akhilamokkapati/pass/actuation/Firmware/data/calibration_run2.csv

weight | measured | fitted | residual
1.200 | -53240.00 | -50995.75 | -2244.25
7.600 | -223719.00 | -223210.56 | -508.44
9.600 | -257718.00 | -277027.69 | 19309.69
10.800 | -325875.00 | -309317.97 | -16557.03
