akhilamokkapati/pass/actuation/Firmware/prototyping/strain_gauge_plot_c3.cpp

// Strain gauge test via HX711 (bridge completed with 3 fixed resistors),
// XIAO ESP32-C3. Formatted output (>name:value) for live plotting.
// Duplicate of strain_gauge_plot.cpp (S3) for the C3 board on COM14.

#include <Arduino.h>
#include <HX711.h>

const int HX711_DT = D9;
const int HX711_SCK = D10;

HX711 scale;

unsigned long lastPrintMs = 0;
const unsigned long PRINT_INTERVAL_MS = 200;

void setup() {
  Serial.begin(115200);
  delay(500);

  scale.begin(HX711_DT, HX711_SCK);
}

void loop() {
  unsigned long now = millis();
  if (now - lastPrintMs < PRINT_INTERVAL_MS) return;
  lastPrintMs = now;

  if (scale.is_ready()) {
    Serial.print(">strain:");
    Serial.println(-scale.read());
  } else {
    Serial.println(F("HX711 not ready"));
  }
}
