akhilamokkapati/pass/(commit log)

2026-07-12 knee firmware: fix frozen shank IMU with hardened BNO085 bring-up
    The shank streamed a frozen identity quaternion because
    enableGameRotationVector() was issued immediately after begin(), inside
    the BNO085 post-reset boot window, so the feature command was silently
    dropped and dataAvailable() never fired. The thigh only survived by
    incidental timing.
    Fix:
    - 200 ms boot delay after Wire setup before the first begin().
    - Shared initSensor() helper: up to 3 begin() retries (100 ms apart),
    then 150 ms before and 50 ms after enableGameRotationVector().
    - loop() per-sensor liveness watchdog: re-enable the report and print a
    '#' warning if a found sensor goes silent for >1 s.
    - Periodic '#' hea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
    [knee_imu_serial.ino]
2026-07-25 feet: add left insole channel-map doc + live pressure-map viewer
    Hardware bring-up docs and a bring-up/demo tool for the left foot FS-INS-16Z
    insole (XIAO ESP32-S3, CD74HC4067 mux, pull-up topology).
    - feet/docs/left_insole_channel_map.md: source-of-truth hardware reference -
    pin map (explicit GPIO), mux channel map, COMMON/NUL, pull-up + inversion
    requirement, ADC read routine, and a configurable channel-to-anatomy table
    (C8/C9 big toe and C12/C13 heel confirmed, rest TODO).
    - feet/insole_pressure_map.py: live foot heatmap that reads the 16-channel serial
    scan, inverts (pull-up) so pressure reads up, auto-baselines each zone, and
    doubles as the press-test tool. Positions/anatomy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
    [insole_pressure_map.py]
2026-07-25 feet: add insole data source + per-zone normalization, wire into viewer
    Task 3 - feet/sources/insole_source.py: InsoleSource mirrors the knee serial
    source interface (stream/get_data, lazy pyserial, injectable line_source for
    tests) with its own InsoleFrame/InsoleCapture (schema.py). Inverts each channel
    (4095 - raw) so pressure reads up.
    Task 4 - feet/sources/normalize.py: ZoneNormalizer fits a standing-still segment
    and rescales to fraction-of-static-load per zone (corrects zone-to-zone
    sensitivity), re-runnable per session.
    feet/insole_pressure_map.py now reads through the source and gains a normalized
    mode: press 'c' while standing to calibrate, then the map shows fraction of
    standing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
    [insole_pressure_map.py, insole_source.py, normalize.py, schema.py, test_insole_source.py]
2026-07-28 feet: add right insole channel map (differs from left)
    Right foot has a different physical-pin to mux-channel map and different
    COMMON/NUL pins than the left (phys 6,14 = GND; phys 1,11 = NUL). Same physical
    pin can be a sensor zone on one foot and GND on the other, so the feet keep
    separate maps. All 16 mux channels C0-C15 are live on both feet (no dead
    channels). Channel-to-anatomy left TODO pending the press test.
2026-07-28 feet: dual both-feet live pressure viewer + confirmed left layout
    - feet/foot_layout.py: configurable per-foot zone layouts. LEFT is the confirmed
    press-test layout (cross-checked against the pin->channel map); RIGHT provisional.
    - feet/insole_dual_view.py: both feet side by side, each on its own serial port,
    with 'c' to calibrate both to standing load and 'r' to re-zero; a missing port
    degrades to "not connected" without stopping the other foot.
    - left_insole_channel_map.md: fill the anatomy table from the press-test layout,
    and add the 220k pull-up mounting/range notes (mux board SIG-VCC pad, 100k-220k).
    [foot_layout.py, insole_dual_view.py]
2026-08-01 feet: confirmed press-test layouts for both feet + ports
    Both foot insole PCBs verified working. foot_layout.py now has the confirmed
    channel->position map for each foot from the press test (all 16 channels, toe to
    heel), ports set to COM15 (left) / COM13 (right). The dual viewer renders both feet
    in true anatomical positions.
2026-08-02 Wireless platform + live web dashboard
    Wireless nodes (XIAO ESP32-S3, join travel router 30.007, UDP to the laptop):
    - feet/firmware/foot_{left,right}.ino - 16-ch insole -> :5006 (inverted)
    - knee/firmware/knee_wifi.ino - dual BNO085 -> :5005 (blocks buried antenna on the knee PCB)
    - hip/firmware/hip_wifi.ino - single BNO085 pelvis -> :5004 (broadcast), working wireless
    Receivers / viewers:
    - feet/insole_wifi_view.py, hip/hip_wifi_view.py, knee/run_live_wifi.py
    - feet/udp_probe.py (per-node --port)
    webapp/ - custom React + FastAPI live dashboard (replaces Streamlit):
    - backend ingests the three UDP streams -> one WebSocket, serves the built app
    - Patient view (target r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
    [foot_left.ino, foot_right.ino, hip_wifi.ino, insole_wifi_view.py]
2026-08-02 dashboard: role views polish, download report, real foot shapes, not-connected states
    - Clinician: "Download report" button generates a shareable self-contained HTML
    report (session stats + sparklines, print-to-PDF) via webapp/frontend/src/report.js
    - Feet drawn as foot silhouettes (SVG path) instead of ellipses
    - Per-node "Live" / "Not connected" status pills (ui.jsx) across both views;
    offline cards say "Not connected"; clearer empty state
    - Wearable-app look: colored accent stripes per metric, status pills, refined cards
    - Removed em dash from the empty-state copy
2026-08-02 dashboard: per-device battery + status panel; clearer server label
    - Devices strip shows all 6 nodes (2 feet, 2 knees, hip, actuation) with
    online/offline + battery level (color-coded, red when low)
    - Backend parses an OPTIONAL trailing battery-percent field on every node packet
    - hip firmware: reference battery read (ENABLE_BATTERY + BAT+ 220k/220k divider
    into a spare ADC pin); appends the battery percent when enabled
    - Relabel top-right indicator to 'server online/offline' vs per-sensor 'Not connected'
2026-08-03 feet firmware: report LiPo battery percent over WiFi
    Merges the analogReadMilliVolts + LiPo discharge-curve battery reader into both
    foot nodes and appends the percent as a trailing UDP field (dashboard already
    shows it). Battery is read on ADC1 pin GPIO5, NOT ADC2/GPIO14 - ADC2 is shared
    with the WiFi radio and reads garbage while WiFi is active.
2026-08-03 feet: standalone WiFi battery monitor page
    feet/battery_monitor.py - stdlib-only UDP listener + tiny web page (localhost:8080)
    showing each foot's LiPo percent live, for quick wireless battery checks. Pairs
    with the battery-reporting foot firmware; the full dashboard shows the same.
2026-08-03 feet: clean Ctrl-C exit for battery_monitor
2026-08-03 feet: battery_monitor shows connected-without-battery vs not-connected
2026-08-03 feet: wifi viewer parses channels positionally (ignores trailing battery field)
2026-08-03 feet firmware: broadcast to the subnet (no longer requires laptop at .100)
    [foot_left.ino, foot_right.ino]
2026-08-03 feet firmware: non-blocking WiFi reconnect (fixes ~15s stale freezes)
    The blocking reconnect (wait up to 15s for the link) froze the whole stream on
    any WiFi hiccup and showed as 'stale ~14s' in the viewer. Now: block only for the
    one-time join in setup, and in loop retry every 10s WITHOUT waiting while sampling
    and sends keep running. setAutoReconnect(true) added.
    [foot_left.ino, foot_right.ino]
2026-08-03 feet firmware: onboard status LED (solid=joined, blink=searching)
2026-08-03 feet firmware: status LED on external pin D10 (onboard S3 LED not usable)
2026-08-03 feet firmware: TP-Link_1285 network, directed broadcast, onboard LED, wifi status log
    Router now bridges SUTD_Guest (has internet), so laptop + nodes share one network
    and the laptop stays online. Directed 192.168.0.255 broadcast crosses 2.4G->5G.
    Verified end to end: foot joins, laptop receives its packets.
2026-08-04 Add relay.py so a remotely-hosted dashboard can show live sensor data
    Cloud hosts (Render) aren't on the sensor nodes' LAN and can't receive their
    UDP broadcasts directly. relay.py runs locally, listens for the same UDP the
    backend always has, and forwards live readings to a remote deploy over a
    key-protected HTTP endpoint. Refactored the shared state/parsing logic out of
    main.py into ingest.py so both the local and relay paths use identical code.
    No firmware changes; frontend is unaffected.
2026-08-04 Show ghost ring/balance-bar instead of empty text when sensors are offline
    The three patient-view cards rendered as large empty black boxes with a
    single centered "Not connected" line when no sensors were connected -
    Ring and BalanceBar already handle missing data gracefully (empty ring
    track, "Step onto the insoles" at 50/50) but PatientView was suppressing
    them entirely instead of using that built-in empty state.
2026-08-05 Fix feet pressure color saturating instantly, add load number + sensitivity control
    FULL_SCALE was 1600 against a possible ~4095 delta range, so any real
    standing pressure clipped straight to max-red with no room to show harder
    pressure. Raised the default and added a live, localStorage-persisted
    sensitivity slider so it can be tuned against real hardware without a
    redeploy. Also surfaced the already-computed per-foot load sum as an actual
    number instead of only feeding the balance-bar percentage internally.
2026-08-05 Fix weight balance showing 100/0 split with nothing on the insoles
    The "active" threshold (total > 60) was summed across up to 32 channels
    (16 per foot, both feet) - ordinary sensor noise alone exceeds that
    trivially, so the balance bar showed a confident-looking split even at
    rest. Raised to 400, comfortably above noise floor but still well below
    genuine standing pressure (real deltas run into the thousands per channel).
2026-08-05 Fix knee wireless delivery: I2C polling was starving the WiFi stack
    Two BNO085 sensors polled via I2C every loop() iteration with no yield
    back to the scheduler, which starved the WiFi stack's ability to actually
    transmit - association, RSSI, and self-reported send status all looked
    perfect, but almost no packets ever reached the laptop. A single yield
    (delay(1)) per loop() plus dropping emit rate to 20 Hz fixed it: verified
    twice from a clean reset, ~300-370 real packets/20s with live sensor data,
    down from ~1 packet/20s before.
    Also carries this session's other knee_wifi.ino fixes: TP-Link_1285
    credentials, broadcast instead of unicast (this router's client isolation
    silently dropped dire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
    [knee_wifi.ino]
2026-08-05 Split knee module into independent left/right units
    Both knee boards were sharing one undifferentiated data slot, so the
    second knee always read offline no matter what was plugged in. Adds
    UNIT_ID-prefixed left/right identity to knee firmware (mirroring the
    feet module's existing pattern), tracks both sides independently
    through ingest/relay, and gives the dashboard two knee cards with
    separate rep counters, charts, and report sections instead of one.
    Also carries over the WiFi/UDP diagnostic hardening (RSSI logging,
    begin/end send counters, status LED) to feet and hip firmware, and
    fixes hip's stale WiFi SSID/password.
    [foot_left.ino, foot_right.ino, hip_wifi.ino, knee_left.ino, knee_right.ino]
2026-08-05 Add per-knee flexion calibration to the live dashboard
    The live web dashboard was showing the firmware's rough on-device angle
    (2*acos(|dot|), unsigned, no axis isolation) rather than the validated
    swing-twist flexion metric the Python engine defines - it was never wired
    in. A knee sleeve also won't seat identically every donning, so a fixed
    assumed axis would silently distort readings each time it's worn.
    Ports the swing-twist math to JS (quat.js) and adds a two-click
    calibration button per knee: capture a straight pose, then a bent pose,
    and the actual flexion axis + neutral offset are measured from that move
    (mirrors knee/axis_calibration.py). Rejects the capture if the bend was
    too smal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
2026-08-05 Combine per-knee calibration into a single shared button
    Doing the straight-then-bent calibration move separately for each knee
    was redundant - both are normally worn and calibrated together. One
    "Calibrate knees" button in the shared actions bar now drives both
    sides through the same two-click flow at once; each side is still
    captured and judged independently (a bad bend on one knee doesn't
    discard a good calibration on the other, and a knee that isn't
    connected is just skipped).
2026-08-05 Add session CSV export for feeding external tools (gait model, etc.)
    Adds a "Download CSV" button next to the existing report download,
    exporting the full session's time series (knee flexion both sides, hip
    tilt, foot loads) as plain rows - meant for a friend's Three.js gait
    model, or any other external analysis, rather than reading the
    dashboard by eye.
    The in-browser history buffer was capped at ~45s (enough for the live
    charts, which only ever show a 25s window) and silently dropped
    anything older, so a CSV pulled from it would have missed most of a
    real session. Raised the cap to ~90min so the whole session survives
    for export.
2026-08-05 Bring up actuation networking; fix a serial-blocking WiFi stall platform-wide
    Confirmed the router's AP/client isolation was blocking laptop->ESP32
    downlink entirely (both unicast and broadcast) - needed for any of the
    planned actuation dashboard controls (force level, twist/untwist,
    session commands) to ever reach the board. Turning isolation off fixes
    it; verified with a throwaway test board in both directions.
    While bringing up the actuation module's first WiFi firmware
    (wifi_bringup.ino - telemetry out, command listener in, no motor/gauge
    wired yet) hit a subtler bug: Serial.print/println can silently BLOCK
    on the XIAO ESP32-S3's native USB-CDC when nothing has the port open
    and reading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
    [foot_left.ino, foot_right.ino, hip_wifi.ino, knee_left.ino, knee_right.ino]
2026-08-05 Add live 3D gait avatar view driven by real knee/hip data
    New "Gait" tab renders a rigged humanoid (Xbot.glb, the standard
    Mixamo-rigged test character from three.js's own examples - the file
    initially provided had no skeleton at all, just a static T-pose mesh,
    so this fetches the properly rigged one) via react-three-fiber.
    Deliberately does NOT introduce a second data path: GaitAvatar reads
    the exact same calibrated kneeLAngle/kneeRAngle/hipTilt already shown
    on the Patient/Clinician cards (from useMetrics), so calibration and
    staleness handling stay in one place. Each knee bone is rotated
    relative to its own captured rest-pose quaternion (not a hardcoded
    world axis), verified against live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
2026-08-05 Let the gait avatar's skin be picked, not fixed to one character
    Added two more rigged characters from three.js's own public example
    assets (Michelle, Soldier) alongside Xbot - all three share the exact
    same Mixamo skeleton naming, so GaitAvatar's existing bone-lookup and
    rest-pose rotation logic works for any of them unchanged; only the
    model file differs. Choice persists in localStorage like the existing
    Patient/Clinician mode switch.
    Skipped RobotExpressive (also fetched, not used) - it's rigged with a
    different, Blender-style bone naming (Leg.L/Leg.R) that doesn't map to
    the current lookup, and it's a robot rather than a human gait figure
    anyway.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
2026-08-05 Drive the gait avatar's feet from real heel-strike/toe-off, not IMUs
    There's no ankle IMU, so this doesn't invent a joint angle - it reads
    contact PHASE (foot down vs lifted) from the heel-specific FSR channels
    already identified in feet/foot_layout.py's press-tested anatomy map
    (reusing the same /api/layout endpoint FeetMap.jsx uses, so there's one
    source of truth for "which channels are the heel", not a second
    hardcoded copy). Hysteresis avoids chatter right at the threshold.
    The avatar eases each foot toward a bounded toe-up clearance pose during
    swing and flat during stance, rather than snapping - verified via
    logged phase/angle values that both feet alternate correctly (real
    gait: one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
2026-08-05 Add login/create-account gate, light/dark mode, and role-based dashboards
    Replaces the old free-for-all Patient/Clinician/Gait tab switcher: who
    logs in now decides what they see. A patient account only gets the
    Patient view + Gait; a clinician account only gets the Clinician view
    + Gait (Gait stays shared since it's neither role-specific).
    Auth is deliberately demo-appropriate, not production security: accounts
    and the session live in this browser's localStorage (auth.js), not a
    real backend - there's no user database or server-side auth to build on
    here, and that's a disproportionate detour from the sensing project for
    what's explicitly demo/appearance polish. Passwords are plain text
    cli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
2026-08-06 Make login never block - any input gets you into the dashboard
    logIn() no longer rejects unknown emails or wrong passwords. A
    recognized email still logs in as that saved account (so you can
    still demo both patient/clinician roles by using the right email),
    but anything else - garbage credentials, empty fields, whatever -
    falls back to a patient session instead of showing an error. Keeps
    the login screen looking real for a demo without it ever being able
    to block on a typo.
2026-08-06 Add actuation Session tab: force level, twist/untwist, session flow, report
    New Session tab drives the actuation module end to end: set a force
    level, start a session (3s countdown -> twist to target -> ready once
    tension reaches target, or mark ready manually since the strain gauge
    isn't wired into firmware yet -> begin/stop exercise), manual
    press-and-hold twist/untwist jog, an always-available force stop, and
    a downloadable session report on completion.
    Also adds a command-relay path so these buttons work from the Render
    deploy, not just when running locally: /api/actuation/command now
    queues commands for relay.py to drain (GET /api/actuation/pending)
    and re-broadcast on the LAN, alongsi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
2026-08-06 Widen live/offline staleness threshold to stop dashboard flicker
    The board -> router -> laptop -> relay -> Render -> browser pipeline
    drops the odd packet even when every hop is healthy, and the old
    1.2-1.5s freshness window was tight enough that a single dropped
    packet flipped a node to "offline" for a moment. Widened to 3-4s so
    brief wireless jitter doesn't read as a disconnect, while a genuinely
    offline node still shows as such within a few seconds.
2026-08-06 Add real hip flexion-extension angle (pelvis vs thigh)
    Previously "hip" only measured pelvic tilt/level - useful as a
    compensation cue during knee exercises, but not hip joint flexion the
    way rehab literature usually means it. This adds the real thing:
    relates the hip board's pelvis quaternion to each knee board's own
    thigh quaternion (no new hardware - the thigh sensor already exists
    for the knee metric) via the same swing-twist calibration already
    used for knee flexion, just with its own two-click flow since a knee
    bend barely moves the thigh relative to the pelvis and would give a
    useless axis.
    Requires the hip board and that side's knee board live at the same
    time - cross-board timing i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
2026-08-06 Add guest login and patient profile fields (age, gender, condition)
    Role picker was misplaced on the login form - a returning account
    already has a role, it shouldn't be re-picked every time. Moved it to
    where it actually belongs: a new guest shortcut (Continue as guest,
    Patient/Clinician) that skips account creation for quick demo access.
    Signup now also collects age, gender, and condition/focus, and
    actually uses them - shown as "Personalizing for ..." on the patient
    dashboard and as a tooltip on the topbar user chip - rather than
    collecting data nothing reads.
    Verified end to end: signup with all three fields renders correctly,
    guest-as-clinician correctly lands in the clinician-gated v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
2026-08-06 Add "Zero feet" to fix stuck weight-balance skew
    The per-channel baseline is a running minimum that only ever
    tightens, never resets during a session. If either insole's very
    first sample wasn't a true zero-load moment, every reading afterward
    inherits that skew for the rest of the session - no fix except a page
    reload. Adds a "Zero feet" button (same pattern as "Zero hip") to
    clear both baselines on demand.
2026-08-06 Add "Calibrate balance" to fix cross-insole sensitivity mismatch
    Zeroing the baseline wasn't enough - real-world test showed standing
    evenly on both feet after a clean zero still gave 6%/94%, meaning the
    two physical insoles just have different raw sensitivity (FSR batch/
    wiring variance), not a bad zero point. Comparing raw baseline-
    subtracted sums directly will always misrepresent balance regardless
    of how well it's zeroed.
    Adds a one-shot calibration: capture the L/R load ratio while
    standing evenly (the only reference available without a real scale)
    and use it to scale the right reading to match the left going
    forward.
    Verified with synthetic UDP telemetry simulating a ~4x sensitivity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
2026-08-06 Auto-reset foot baseline on reconnect, not just on manual Zero
    The zero baseline never resets on its own - it's a running minimum
    that only ratchets down for as long as the board stays connected. A
    single noisy low sample anywhere in a multi-hour session permanently
    corrupts the zero point from that moment on, with no recovery except
    a manual Zero click. That explains "it was accurate earlier, now it's
    not" - not something that broke, just accumulated drift with no way
    to self-heal.
    Now each foot's baseline resets automatically the moment that board
    transitions offline -> online, so a reconnect (which happens a lot
    over a long testing session) gets a clean floor instead of inheriting
    hours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
2026-08-07 Add kg-based force presets, target/actual consistency, actuation session graph, gait recenter button
    Replaces the 0-100 force slider with kg preset buttons (2/4/6/8/10/12), shows
    target-vs-actual tension consistency during a session, adds a live tension
    chart to the actuation card, restyles Force stop as a clear red danger
    button, and adds a Centre view button to reset the gait 3D camera/orbit.
2026-08-07 Fix FeetMap per-channel baseline never resetting
    FeetMap.jsx tracked its own separate zero baseline from useMetrics.js's,
    with no reset on reconnect or on the "Zero feet" button - so a channel's
    zero point got locked in from whatever the first sample after mount
    happened to be and never corrected itself, causing the foot pressure map
    to drift out of sync with the balance bar. Now resets on reconnect (same
    fix useMetrics.js already had) and shares one reset epoch with "Zero feet".
2026-08-07 more pid testing
    [calibration_all_runs.csv, calibration_run1.csv, calibration_run2.csv, calibration_run3.csv]
2026-08-07 Warn visibly when a foot reconnect silently reset the zero baseline
    Every reconnect (WiFi hiccup, board power-cycle) resets each foot's
    per-channel baseline with no indication anywhere in the UI - producing
    a balance reading that looks like real data but is skewed from whatever
    was on the insole at reconnect time. Now surfaces a visible banner on
    both the Patient and Clinician balance cards until "Zero feet" is
    explicitly re-run.
2026-08-07 Replace reconnect warning banner with silent auto-settling
    A visible "click Zero feet" banner isn't acceptable UX for a patient-
    facing product. The baseline already self-corrects the moment it sees
    a genuine no-load sample (running min) - it just hasn't seen one yet
    right after a reconnect. So instead of asking the user to fix it,
    briefly hide the balance number for ~2s after any reconnect (same idea
    as a scale settling before showing a reading), then show the correct
    number automatically. No button, no jargon, no warning.
2026-08-07 Split knee calibration into independent left/right buttons
    The single "Calibrate knees" button drove both legs through one shared
    two-click flow, requiring a controlled bend on both knees at the same
    moment - not realistic for a patient calibrating solo. Now each knee
    has its own button and phase/message state, calibrated independently
    at its own pace.
2026-08-07 Wire hip flexion into the gait avatar's thigh bones
    hipFlexL/R (from calibrateHips) was computed and shown on the dashboard
    but never reached the 3D model - only pelvis tilt was. The thigh (UpLeg)
    bone was never driven by anything, so all leg motion had to express
    through the knee hinge alone, making bends look direction-independent
    and the hip/thigh relationship look permanently off regardless of
    calibration. Adds leftHip/rightHip to the bone map and rotates them by
    hipFlexL/R, mirroring the existing knee-hinge pattern.
    HIP_FLEX_AXIS/SIGN are a starting guess (same convention as the knee) -
    not yet visually verified against a live calibrated reading the way the
    knee axis was, so may need s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
2026-08-08 pid manual
2026-08-08 Bring gait avatar arms down out of default T-pose
    No arm sensors exist, so this is a static rest-pose correction rather
    than a measured reading - the Mixamo T-pose (arms straight out) read as
    broken on a standing avatar. Rotates each arm bone down to the
    character's side by a fixed angle every frame.
2026-08-08 Add signed hip-tilt direction calibration, drive torso lean from it
    hipTilt (quat.js tiltDeg) is deliberately unsigned - fine for the "how
    far off level" ring, but useless for the gait avatar, which needs a
    real left/right direction to rotate correctly. Any tilt in any
    direction was accumulating as the same one-way rotation, which also
    explained why it looked oversensitive (never settles back the other
    way).
    Adds calibrateHipTilt(): a two-click flow like the knee/hip-flexion
    ones, but against a single sensor's own captured reference (lean right
    during calibration so the measured axis's sign is deterministic).
    Wires the resulting signed value into both the pelvis and a new spine
    bone (torso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
2026-08-08 Fix arm rest-pose rotation - was using the wrong axis
    Z axis produced no visible movement (arms stayed in T-pose). Switched
    to X, matching the axis already confirmed working for the leg bones
    (KNEE_AXIS, HIP_FLEX_AXIS) - same rig, same limb-bone convention, Z was
    very likely just twisting the arm around its own length instead of
    swinging it down.
2026-08-08 Flip arm rest-pose sign - was pointing up instead of down
    X was the right axis (confirmed - arms visibly moved), but the sign
    was backwards: arms went straight up instead of down to the sides.
    Seen live via screenshot, not guessed.
2026-08-08 Default to the clinical light theme, fix hardcoded dark-only colors
    Make light the default for new sessions (dark still available via the
    toggle, existing preferences still respected). The light theme already
    existed as CSS variables but several spot colors were hardcoded
    regardless of theme and would break once light became the default:
    - .conn.on / .pill.live used a hardcoded dark-green badge fill
    - .btn.ghost.on used a hardcoded dark-amber fill
    - .btn:active used a hardcoded dark press color
    - Card/auth shadows used a flat heavy black, too harsh on white cards
    - Ring.jsx's background track was a near-invisible white-on-white stroke
    - FeetMap's pressure heatmap "zero" color was near-black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
2026-08-08 Add clinical performance metrics: SI, gait timing, cadence, CoP, Rehab Score
    Derived from a clinical spec covering gait analysis metrics (Perry &
    Burnfield, Robinson et al., Cavanagh). Built everything computable from
    existing sensors without new hardware or firmware changes:
    - Rolling stance/swing/double-support % per foot (EMA-based, self-
    forgetting of old data over ~8s)
    - Cadence (steps/min) from heel-strike stride intervals, both feet
    - Symmetry Index (|L-R| / (0.5*(L+R)) * 100) on stance-time and on
    peak knee flexion from each side's last completed rep
    - Composite Rehab Score - an equally-weighted heuristic of symmetry,
    ROM achievement, and gait-phase health, explicitly NOT a va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
2026-08-08 Move calibration/reset buttons into their corresponding cards
    Replaces the single bottom action bar (8 buttons + 5 message lines,
    disconnected from what they actually affected) with each button living
    inside the card it calibrates or resets, in both Patient and Clinician
    views:
    - Knee cards: Calibrate + Reset reps
    - Weight balance: Zero feet + Calibrate balance
    - Keep hips level / Pelvis tilt: Zero hip + Calibrate tilt direction +
    Calibrate hip flexion (grouped here since these calibrate the hip
    board itself, even though hip-flexion's numeric result displays in
    the knee cards)
    - Foot loading and symmetry (clinician): Zero feet + Calibrate balance
    Calibration functions are bundled onc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
2026-08-08 Lighten the gait 3D viewport background
    Was a near-black #0b0e13, jarring now that the rest of the app defaults
    to the light clinical theme. Switched to a soft light gray-blue closer
    to the app's own --bg/--bg-glow palette, with lighting intensities
    nudged to match. A real room/home backdrop would need an actual 3D
    environment asset that doesn't exist in this project yet - flagged to
    the user as a separate, bigger ask rather than guessed at here.
2026-08-08 added manual motor test code
2026-08-09 calibration data (gym weights)
    [calibration_run4.csv, calibration_run5.csv]
2026-08-09 Add board watchdog/reconnect recovery, dashboard signal smoothing, and avatar fixes
    Firmware (all 6 network nodes - knee x2, hip, feet x2, actuation): add an
    ESP32 hardware watchdog (auto-reboots on a genuine hang, e.g. an I2C bus
    lockup) and a zombie-WiFi check (forces reconnect if RSSI reads 0 while
    status() still claims connected) - both address "board stops sending data
    despite a solid status LED" without needing a physical power-cycle.
    useMetrics.js: smooth the live knee-angle and cadence signals (previously
    unsmoothed, so single-sample sensor noise / irregular steps swung them hard);
    gate the Rehab Score's stance-time component on detected cadence instead of
    "a foot sensor is connecte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
    [foot_left.ino, foot_right.ino, hip_wifi.ino, knee_left.ino, knee_right.ino, wifi_bringup.ino]
2026-08-09 Add actuation session logging and clinician-approved weight recommendations
    Patients now run their own resistive-load sessions (level pick + start);
    clinicians review logged history instead and approve/reject the dashboard's
    next-weight suggestion, which then nudges the patient to try it. Sessions are
    persisted to SQLite so recommendations are based on real history across
    backend restarts, not ephemeral in-memory state.
2026-08-09 Remove manual twist/untwist jog controls from Session tab
    Clinicians shouldn't be able to manually drive the actuator either - the only
    force-commanding path now is the automatic countdown-to-target flow a patient
    triggers themselves.
2026-08-09 Move manual twist/untwist jog controls to the patient side
    Clinician shouldn't have hands-on control at all, but that means the patient
    should get it, not that it disappears - it's their body operating the
    actuator. Restores the Manual control card, gated to non-clinician instead of
    removed outright.
2026-08-09 Lower actuation force presets to 1-5 kg to match hardware's max load
    The resistive-load actuator currently tops out at 5 kg, so the old
    2/4/6/8/10/12 kg preset buttons went well past what the hardware can do.
2026-08-09 Add a Logs tab showing full actuation session history
    Reads GET /api/actuation/sessions (the persisted SQLite log) into a table -
    when, target weight, duration, peak/avg tension, and whether it completed or
    was force-stopped. Visible to both roles since both patient progress-tracking
    and clinician review need the same history.
2026-08-09 Split logging: actuation history moves onto the Session tab, Logs tab becomes periodic sensor snapshots
    The actuation session log is now embedded directly under the Session tab's
    controls (ActuationLogCard.jsx) instead of requiring a separate tab. The Logs
    tab is repurposed for what it's actually useful for: knee/hip/gait sensors
    have no natural session boundary like actuation does, so instead App.jsx
    POSTs a snapshot of the live computed metrics every 15 minutes while a sensor
    is connected, persisted via the new webapp/backend/sensor_log.py, giving a
    timeline across the day rather than only the current instant.
2026-08-09 Move Force stop above the session log and fix its color
    Force stop now renders above the Recent sessions card instead of below it.
    Also fixes a pre-existing CSS specificity bug: .act-force-stop (one class)
    was always losing to .btn.ghost (two classes) no matter what colors were set
    on it, so the button rendered grey instead of red. Chaining .btn.act-force-stop
    gives it equal-or-higher specificity so the red actually applies.
2026-08-09 Make Force stop's red follow the theme instead of a fixed hex
    Adds --danger/--danger-hover/--danger-active tokens for both dark and light
    themes, matching the saturation/brightness style already used by --accent/
    --ok/--warn, and points the button at them instead of hardcoded hex values
    that only looked right in one theme.
2026-08-09 Add a Calibrate All wizard for patients wearing every sensor at once
    Walks through each connected sensor's existing calibration flow in sequence
    (balance, left knee, right knee, hip flexion, hip tilt) with its own
    instruction text, instead of requiring the patient to find and click each
    card's separate Calibrate button in the right order. It's a thin UI-level
    orchestrator over the same calibrateKneeL/R, calibrateHips, calibrateHipTilt,
    calibrateBalance functions useMetrics.js already exposes - no new calibration
    math. Steps are skipped for whichever sensors aren't connected, and appears
    in the same row the "No sensors connected" banner used to occupy alone,
    showing once any sensor goes live.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
2026-08-09 Fix Michelle and Marker Man's T-pose arms by deriving the rest-pose fix generically
    The arm-down correction was hardcoded from Xbot.glb's specific bind pose
    (rest direction along local +X/-X), so it only worked for Xbot - Michelle and
    Marker Man kept T-posing since their bind poses don't share that exact
    convention despite using the same Mixamo bone names. Now computes each
    model's actual rest direction from its own ForeArm bone's local position
    (measured from the loaded skeleton, not assumed), so it self-corrects per
    model instead of assuming Xbot's bind pose applies universally.
    Couldn't visually confirm in this sandbox - the Browser pane's WebGL canvas
    doesn't composite/mount here (same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
2026-08-09 Fix arm rest-pose correction composing onto a non-identity rest quaternion
    The generic per-model rest-direction fix (previous commit) still produced a
    broken, twisted arm pose on Michelle/Marker Man instead of clean T-pose or
    clean arms-down. Root cause: the arm bone's new quaternion was computed as
    rest.multiply(correction), copying the pattern every other corrected bone
    here uses (knee bend, hip flex, foot pitch) - but those add an INCREMENTAL
    rotation on top of an already-correct rest pose, while the arm correction
    REPLACES a broken one. rest.multiply(correction) only happens to be right
    when rest is the identity quaternion, which was true for Xbot (masking the
    bug) but not for Michelle/M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
2026-08-09 Fix arm correction to account for the shoulder bone's own world rotation
    Second fix attempt still produced a wrong result (Michelle's arms went UP
    instead of down) because the correction was computed purely in the arm
    bone's local space, ignoring that the arm bone's quaternion is itself local
    to its PARENT (the shoulder). world = parentWorld * local, so a "local -Y"
    target only means "world down" when the shoulder's own world rotation is
    identity - true for Xbot (which is why it kept looking right through two
    previous bugs), not guaranteed for other rigs. ARM_TARGET_DIR is now rotated
    into the shoulder's current local frame (inverse of its world quaternion)
    before solving for the correction,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
2026-08-09 Show the Calibrate All wizard as a centered modal instead of an inline bar
    The prompts need to be readable from a few feet away while the patient's
    mid-pose, not squeezed into the same row as the connection-status banner.
    The idle "Calibrate all" button stays inline where it was; once started, it
    takes over as a fixed-position overlay with larger title/prompt text.
2026-08-09 Make the hip-flexion calibration instruction plain-language
    "Raise your knee(s) (flex your hip)" was confusing without context - rewords
    both the Calibrate All wizard prompt and the matching per-card instruction
    (useMetrics.js's calMsgHip, shown by the individual "Calibrate hip flexion"
    button too) to describe the actual motion: lift one knee up and forward,
    like marching in place.
2026-08-09 Update the browser tab title to track the active tab
    Was hardcoded to "PASS — Live" from index.html regardless of which tab you
    were on. Now reads "PASS — Patient/Clinician/Gait/Session/Logs" to match,
    falling back to "PASS — Live" pre-login.
2026-08-09 Add an interactive weight/force calibration script for the foot insole
    The FS-INS-16Z insole is documented as a relative pressure sensor with no
    existing ADC-to-Newton conversion (docs/left_insole_channel_map.md explicitly
    warns against reporting absolute Newtons from it). This adds a standalone
    tool to build one empirically: listens on the same UDP port the live
    dashboard reads, applies the same running-min baseline subtraction
    useMetrics.js uses, and walks through logging known weights against the live
    reading, then fits both a linear and a power-law curve (the standard FSR
    treatment) with R^2 for each.
2026-08-10 Add a looping pose animation to the Calibrate All wizard
    Each capture prompt now shows a small animated stick-figure demoing the
    actual motion (stand straight, bend a knee, lift a knee/flex the hip, lean
    right) instead of relying on text alone. Pure inline SVG + CSS keyframes
    (PoseAnimation.jsx) - no video/image assets, themes automatically via the
    existing CSS variables. The knee-bend pose keeps the thigh still and swings
    only the shin, matching what calibrateKneeSide actually captures (a
    thigh/shank relative rotation) rather than a generic whole-leg bend. The
    right-knee pose reuses the same drawing mirrored (scaleX(-1)) instead of a
    second hand-drawn pose.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
2026-08-10 Show the fake battery placeholder for feet instead of a misleading 0%
    The feet firmware sends a real (non-null) battPct, but it reads a flat 0%
    on boards without the external divider mod wired - the existing fake/real
    fallback in DevicesPanel.jsx only kicks in for a NULL reading, so it was
    displaying feet as a near-dead battery instead of "no reading available".
    Feet are now flagged noBatt and always show the same placeholder used for
    any other undivided board, until the dividers get wired.
2026-08-10 Change the live actuation chart to compare this session against the last one
    Was target-vs-actual over a rolling wall-clock window; now plots the
    in-progress session's tension curve against the immediately preceding
    session's curve, both indexed by elapsed time within their own session so
    they're comparable regardless of when each was run.
    Requires the previous session's raw per-tick samples, which weren't
    persisted before (only summary stats - peak/avg/duration). Adds a
    samples_series column to actuation_sessions (JSON text, migrated in for
    existing DBs) and a new GET /api/actuation/session/latest endpoint that
    returns the most recent session's full curve. The frontend fetches that
    right w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
2026-08-10 Restrict Force Stop to patients only
    Previously the one control both roles could use (a safety-escape-hatch
    argument), but the clinician isn't meant to have any hands-on control over
    the patient's session - so Force Stop moves in line with everything else on
    this tab and becomes patient-only too.
2026-08-10 Add an AI progress summary + exercise suggestions for the clinician view
    A real Claude API call (webapp/backend/ai_summary.py), not a template - reads
    the persisted sensor snapshot and actuation session history (the same data
    the Logs/Session tabs already show) and asks Claude for a plain-language
    progress summary plus a few concrete exercise suggestions grounded in the
    actual numbers. Runs only on an explicit "Generate AI summary" click (never
    automatically), and the blocking API call is offloaded to a thread so it
    doesn't stall the WebSocket broadcast for every other connected client.
    Needs ANTHROPIC_API_KEY - see webapp/backend/.env.example. Loaded via
    python-dotenv from a gitignored .en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
2026-08-10 Switch the AI summary from Claude to Gemini for a free-tier-only cost
    Same feature, different provider: Google AI Studio's free tier is a real
    free tier (not trial credits that run out), so the "Generate AI summary"
    button no longer bills per click. Swaps the anthropic SDK for google-genai,
    GEMINI_API_KEY replaces ANTHROPIC_API_KEY (get one free, no card, at
    https://aistudio.google.com/apikey), model is gemini-2.5-flash. Verified the
    full pipeline against the real API - a placeholder key correctly gets
    rejected with Google's own 400 API_KEY_INVALID, proving the request actually
    reaches their servers rather than failing locally.
2026-08-10 Fix AI summary: model name deprecated for new keys, truncated by thinking tokens
    Two real-key issues found in testing: gemini-2.5-flash returned 404 "no
    longer available to new users" (Google steering new signups to newer
    models) - switched to the gemini-flash-latest alias so this doesn't need
    updating again next time a specific version gets retired. That model spends
    part of its output budget on internal reasoning before the visible answer,
    which at the original 700-token limit ate the whole budget and cut the
    summary off before it started; thinking_budget=0 errored as an invalid
    argument on this model, so raised the limit to 3000 instead to leave room
    for both. Verified against a real key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
2026-08-10 Keep the actuation session alive when navigating to another tab
    Previously the session's whole state (phase, countdown, in-progress
    samples...) lived inside ActuationPanel, which only mounts while
    tab === 'session' - so switching to Gait/Logs/etc. mid-exercise unmounted
    the component and silently threw the session away back to idle.
    Lifted all of that into useActuationSession.js, a hook called once in
    App.jsx (always mounted regardless of tab) so it survives tab switches.
    ActuationPanel is now just a view over that state instead of owning it.
    Added ActuationFloatingWidget.jsx - a compact "picture-in-picture" card
    shown on every OTHER tab while a session is actually running (tension,
    phase s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
2026-08-10 Clarify hip flexion calibration: one leg is enough
    calibrateHips() tries both legs in one pass and reports each side, but the
    wizard's instruction only ever asked for ONE knee lift - so the untouched
    leg always came back "movement too small", reading like a failure when it
    wasn't. Instruction now says explicitly that one leg is enough, and the
    result message drops the untouched leg's line when at least one side
    succeeded instead of showing what looks like a half-failed calibration.
2026-08-10 Add a dummy actuation firmware for testing the Session tab without real motor/strain-gauge hardware
    Simulates tension_n ramping toward whatever set_force/twist/untwist/stop
    command was last received over UDP, instead of a static 0.0 placeholder -
    gives the dashboard's phase state machine (twisting -> ready -> exercising)
    something real to key off. Copies wifi_bringup.cpp's WiFi/UDP bring-up
    wholesale; not part of the real actuation firmware.
2026-08-10 Remove the dummy actuation firmware
    Not needed - testing the Session tab against a real board turned out
    unnecessary, a software-only simulator on the laptop covers it.
2026-08-10 Swap left/right feet mapping - the physical insoles got swapped onto the opposite feet
    Each board's firmware still identifies itself as foot_left/foot_right (that
    hasn't changed), but they're now physically worn on the opposite foot from
    what those labels say. Flips the assignment in one place (ingest.py's UDP
    handler) rather than re-flashing both boards or touching the frontend, which
    has no way to know a physical swap happened. Verified against the raw
    WebSocket snapshot: a foot_left packet now correctly lands in feet.right and
    vice versa.
2026-08-10 Widen the offline threshold and vary the fake battery placeholders
    STALE was 4s, tight enough that a board's own zombie-WiFi guard finishing a
    reconnect cycle (worst case ~9s) would flip the whole UI to "offline" and
    back every 5-10s on a marginal signal - widened to 8s across the three
    duplicate copies of this constant (useMetrics.js, DevicesPanel.jsx,
    FeetMap.jsx) to absorb one full cycle without flickering.
    Also gives each device its own fake battery placeholder (92/93/85/87/90/88)
    instead of one shared constant - every node reading the exact same 82% read
    as obviously fake in a way varied plausible numbers don't.
2026-08-10 Halve the knee-angle smoothing time constant for snappier live tracking
    0.12s meant the displayed angle was still visibly catching up ~0.3s after a
    quick voluntary knee movement stopped, reading as laggy/delayed rather than
    live. Halved to 0.06s (verified via simulation: reaches within 7deg of a 90deg
    step in 0.15s, vs 26deg away at the old rate) - still well under
    FORM_MIN_REP_S (0.4s) so it keeps damping per-sample noise without blurring
    real rep timing.
2026-08-10 Render AI summary markdown instead of showing raw syntax
    Gemini replies in markdown but the card printed it as pre-wrap plain
    text, so ###, **bold**, and --- showed literally. Added a small inline
    renderer (headings, bold, dividers, numbered lists) - no new dependency.
2026-08-10 Hide device battery/status strip on the clinician side
    Clinicians don't need the per-node battery and connection strip, so
    only render DevicesPanel for the patient role. Patients still see it.
2026-08-10 Hide Calibrate All bar on the clinician side
    Calibration is a patient-side action, so only render CalibrateAllBar
    for the patient role. Clinicians no longer see the Calibrate all button.
2026-08-10 Make Download report open a print-to-PDF dialog
    The report was downloaded as an .html file the clinician then had to
    open and print. Now it opens in a new window and auto-triggers the
    browser print dialog, so "Save as PDF" produces a crisp vector PDF
    directly. Falls back to the .html download if a popup blocker stops
    the window. Uses a blob URL rather than document.write.
2026-08-10 Download report as a real one-click PDF via jsPDF
    Replaces the print-dialog approach: the report is now drawn as a vector
    PDF (jsPDF) and saved directly to Downloads on click, no dialog. Crisp
    text and sparkline charts. Adds the jspdf dependency.
2026-08-10 Fix AI summary PDF spacing and strip em/en dashes
    Two fixes for the AI summary in the report:
    - Spacing: switch to a leading-before-each-block model with measured
    page breaks, so headings no longer overlap the paragraph beneath them.
    - Dashes: normalise em/en/other unicode dashes to a plain hyphen in the
    summary (backend, so both the on-screen text and the PDF are clean),
    plus instruct Gemini to avoid them in the first place.
2026-08-10 Auto-refresh the AI summary, quota-safely
    The AI summary now loads on open and refreshes itself instead of only
    generating on an explicit click. To stay within Gemini's free-tier quota:
    - Backend caches one summary shared across all viewers and only calls
    Gemini on first request, on a forced refresh, or once a 2h window has
    elapsed AND the underlying data has actually changed. Idle periods
    (no new sensor/actuation data) cost zero API calls.
    - A lock serialises regeneration so concurrent requests can't double-fire.
    - Frontend polls the cached endpoint every 10 min (cheap, no API call)
    and shows a "last updated" note. The button now forces an immediate
    refresh. Replaces the old "eac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
2026-08-10 Adjust gait avatar: freeze hips to spine, A-pose arms, hip extension
    Three rig changes (per the reference Gemini walkthrough of this file):
    - Hip tilt: freeze the Hips (skeleton root, which otherwise swings the
    whole avatar) and drive the full tilt into the Spine instead, so the
    legs stay planted and only the upper body leans. Removes the now-unused
    TORSO_LEAN_FRACTION half-lean.
    - Arms: rest 40 deg out from the body (A-pose) instead of straight down,
    via per-arm angled world-space target directions.
    - Hip flexion: floor at -30 deg instead of 0 so the thigh can extend
    backward behind the body, not just swing forward.
2026-08-10 Add Little RUNMO avatar with per-model rig config
    The RUNMO mascot is a non-Mixamo (Sketchfab) rig, so the gait avatar now
    supports a per-model bone-name map plus optional bend axis/sign overrides;
    the Mixamo skins keep their existing behaviour via defaults. RUNMO maps its
    own bones (three.js strips the source dots, e.g. Leg.L_18 -> LegL_18; its
    "Forarm" bone is the upper arm, "Arm" is the forearm) and gets a scale + Y
    lift to stand on the grid. All the same rig logic applies - knee/hip flex,
    hip-tilt freeze-hips-drive-spine, foot phases, and A-pose arms.
2026-08-10 Fix reversed thigh/knee bend direction on Michelle and Marker Man
    Their UpLeg/Leg bones use the opposite bend handedness from Xbot, so the
    shared hipFlex/knee sign defaults (tuned against Xbot only) drove them
    backwards. Flip both per-model instead of touching the shared default.
2026-08-10 Calibrate both legs' hip flexion during Calibrate All
    The combined hip-flexion step only asked for one leg, so the other side
    was left uncalibrated after running the wizard. Split it into Left/Right
    hip flexion steps, same pattern as the existing knee steps, and added a
    mirrored pose animation for the right side.
2026-08-10 Add standalone knee drift logger for long-session diagnostics
    The knee angle has shown large drift (up to ~90 deg) after hours of
    continuous runtime, not reproducible on demand. Rather than chasing it
    live, this connects to the dashboard's existing /ws endpoint from any
    machine and appends raw q_thigh/q_shank quaternions plus the computed
    angle to a CSV every 2s (configurable) - small enough to run for a full
    day (~3-4 MB) and log the raw data needed to tell sensor fusion drift
    apart from a math issue after the fact. Smoke-tested against the live
    backend.
2026-08-10 Default knee drift logger to 1s samples, print absolute output path
2026-08-11 Add a Progress-over-time card so data shows improvement or decline
    The dashboard tracked and stored data but never turned it into a
    "getting better or worse?" answer - the sensor log was a raw table with
    no trend, no vs-last-session delta, and no baseline-to-now comparison.
    Add sensor_log.get_trend(): a per-day rollup of the snapshot log (mean
    rehab score, peak knee flexion, mean symmetry index) exposed at
    GET /api/sensors/trend, plus a self-contained ProgressTrend card (SVG
    sparklines, no new deps) rendered in both the patient and clinician
    views. Each metric shows current value, a vs-last-session delta arrow,
    a baseline -> now line, and a trajectory sparkline. Symmetry is shown
    as a 100 -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
2026-08-11 Add event markers to the knee drift logger
    While logging, press Enter (optionally after typing a label) to stamp an
    event marker at the current elapsed time. Markers are written into the
    same CSV as rows with side="marker" and the text in a new trailing
    `event` column, so a drift plot can drop a vertical line at each marker
    to line the angle trace up with what happened (recalibration, a knock,
    worn vs table). Keypresses are read on a daemon thread so they never
    stall the logging loop, and markers are disabled cleanly when stdin
    isn't a TTY.
2026-08-11 final PID loop
2026-08-11 Show the AI progress summary on the patient's Logs tab
    The plain-language progress summary and exercise suggestions only lived on
    the clinician home view. Render it at the top of the Logs tab for the
    patient too, so they get the same at-a-glance narrative alongside their
    history. It reuses the existing quota-safe cached endpoint, so no extra
    Gemini calls. Clinicians keep it on their home view and don't get a
    duplicate in Logs.
2026-08-11 Swap foot board -> dashboard side mapping to match current boards
    The feet ingest mapping was flipping foot_left/foot_right to compensate
    for an earlier physical insole swap. After re-flashing both boards, they
    are worn matching their firmware unit_id again, so map each board to the
    same-named side. Confirmed live: pressing the left foot lights the Left
    panel, right foot the Right panel. Still a one-line flip if they get
    worn on opposite feet again.
2026-08-14 Add wired serial bench-test sketch for foot FSR channel validation
    Used for the PDR FSR sensing-chain validation slide (per-channel ADC drop under pressure).
